Logan-Fouts/Plink/hardware/plink_freecad/Plink Models.FCStd

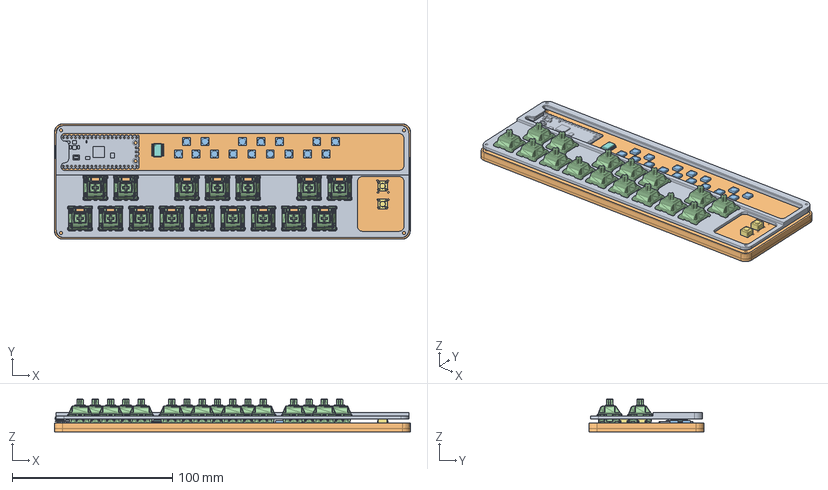
[picture p2: CAD file, 2026-11-08]
hardware/plink_freecad/Plink Models.FCStd
222.1 x 72.0 x 20.4 mm
Top Plate v1.0
Pcb_fa8d
LED3_SMD Neopixel 5050_70e6c0d70468 x 16
STEP translator 7.5 1.1 x 16
STEP translator 7.5 1.2 x 16
STEP translator 7.5 1.3 x 16
SW1_SW_PUSH_6mm_0a506ad786f1 x 2
BODY_MSA24
LEAD_MSA24
LEAD_MSA001
LEAD_MSA002
LEAD_MSA003
LEAD_MSA004
LEAD_MSA005
LEAD_MSA006
LEAD_MSA007
LEAD_MSA008
LEAD_MSA009
LEAD_MSA010
LEAD_MSA011
LEAD_MSA012
LEAD_MSA013
LEAD_MSA014
LEAD_MSA015
LEAD_MSA016
LEAD_MSA017
LEAD_MSA018
LEAD_MSA019
LEAD_MSA020
LEAD_MSA021
LEAD_MSA022
LEAD_MSA023
RaspberryPi_Pico_Module_KiCad
Bottom Plate
