Logan-Fouts/Plink/hardware/plink_kicad/CD74HC4067_Breakout/Plink Models-CD74HC4067 Breakout.step

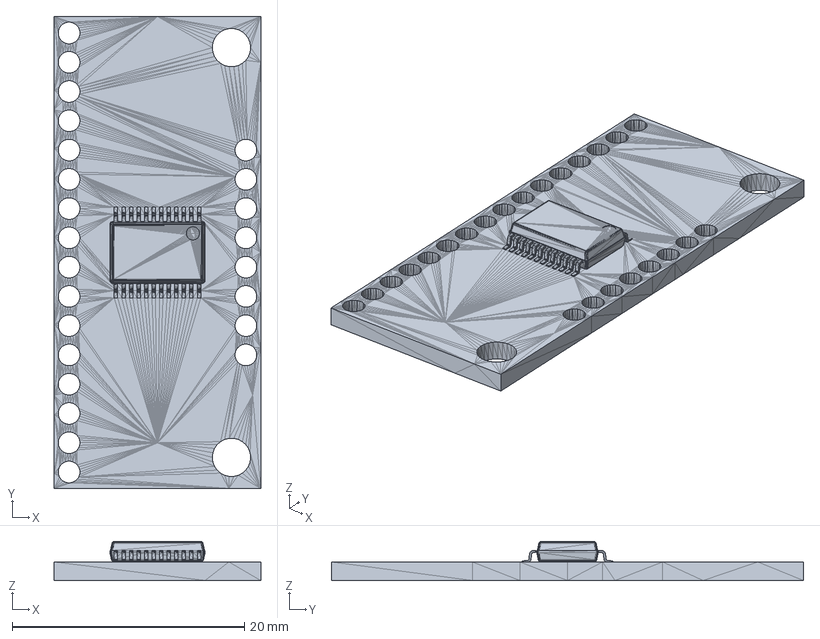
[picture p3: CAD file, 2026-10-27]
hardware/plink_kicad/CD74HC4067_Breakout/Plink Models-CD74HC4067 Breakout.step
17.8 x 40.6 x 3.36 mm
