Logan-Fouts/Plink/hardware/plink_kicad/CD74HC4067_Breakout/ul_CD74HC4067SM96/DB0024A.stp

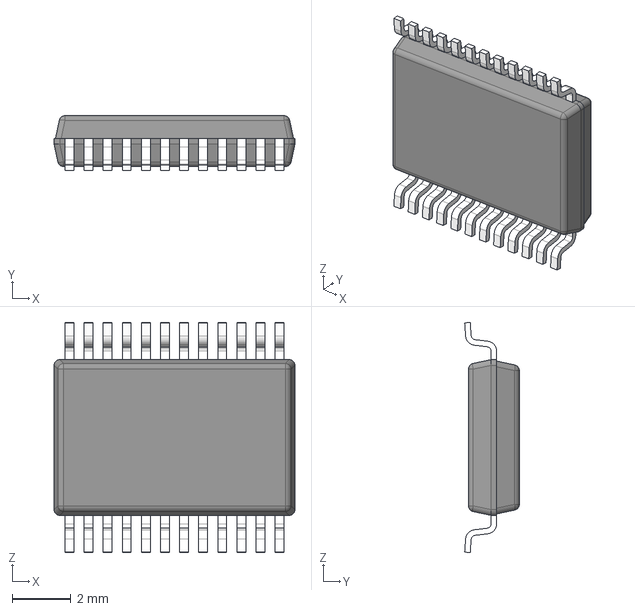
[picture p4: CAD file, 2026-10-27]
hardware/plink_kicad/CD74HC4067_Breakout/ul_CD74HC4067SM96/DB0024A.stp
8.20 x 1.86 x 7.83 mm
BODY_MSA24
LEAD_MSA24 x 24
