Logan-Fouts/Plink/hardware/plink_freecad/Plink Models-Top Plate v1.0.step

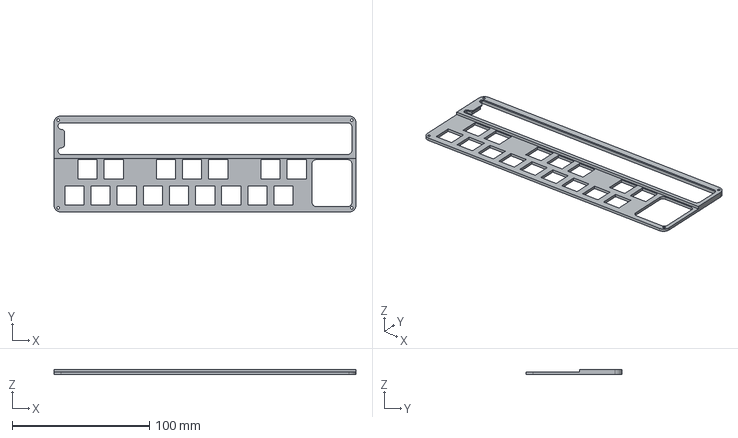
[picture p5: CAD file, 2026-11-03]
hardware/plink_freecad/Plink Models-Top Plate v1.0.step
220.0 x 70.0 x 4.00 mm
