Logan-Fouts/Plink/hardware/plink_freecad/Plink Models-Rotary Encoder.step

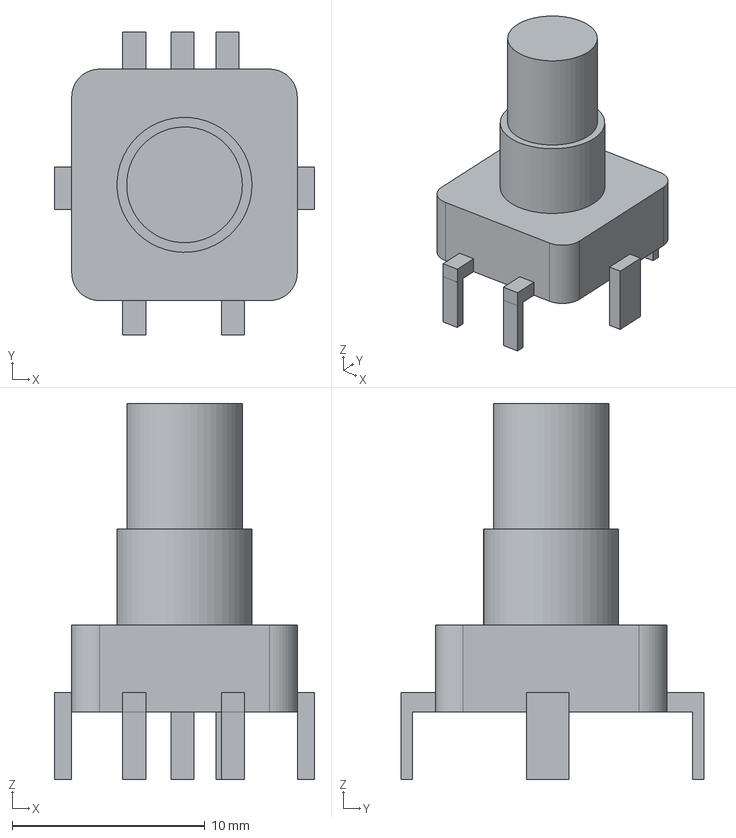
[picture p6: CAD file, 2026-11-02]
hardware/plink_freecad/Plink Models-Rotary Encoder.step
13.5 x 15.7 x 19.5 mm
