Logan-Fouts/Plink/hardware/plink_freecad/Plink Models-SMD Neopixel 5050.step

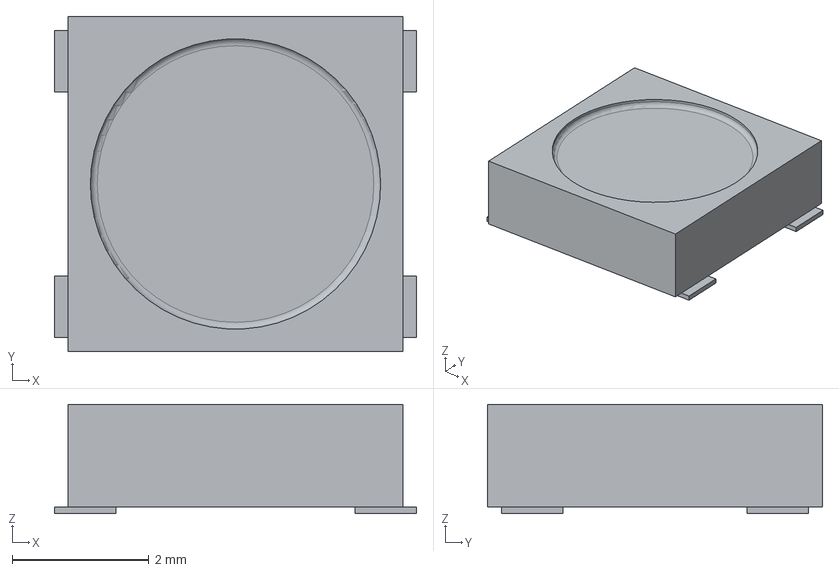
[picture p7: CAD file, 2026-10-25]
hardware/plink_freecad/Plink Models-SMD Neopixel 5050.step
5.30 x 4.90 x 1.60 mm
