Logan-Fouts/Plink/hardware/plink_freecad/8mm Neopixel.step

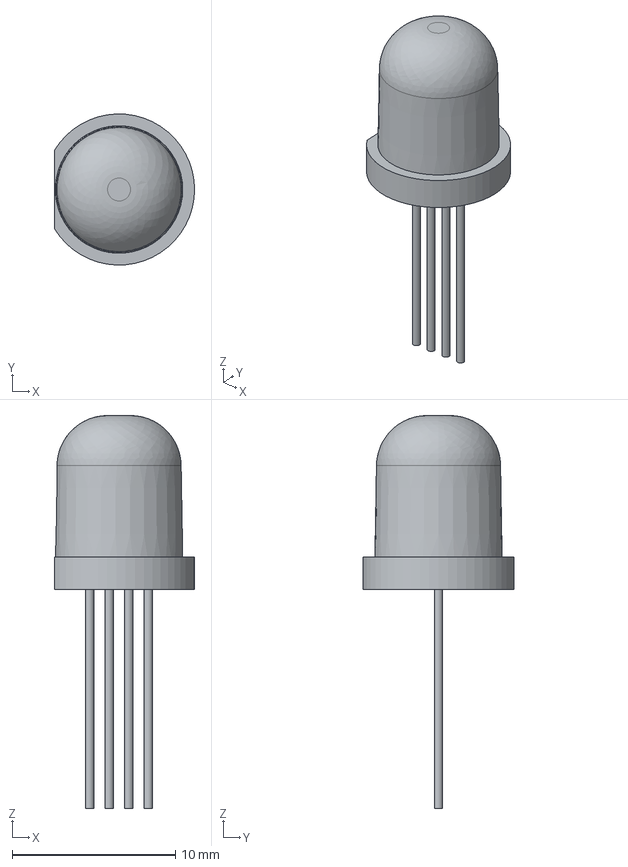
[picture p8: CAD file, 2026-10-25]
hardware/plink_freecad/8mm Neopixel.step
8.58 x 9.24 x 24.1 mm
