Logan-Fouts/Plink/hardware/plink_freecad/SS49 SIP-3 Hall Sensor-SS49 SIP-3 Body.step

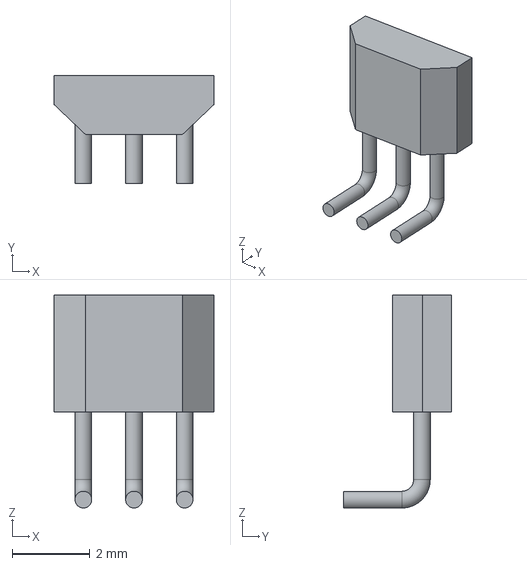
[picture p9: CAD file, 2026-10-25]
hardware/plink_freecad/SS49 SIP-3 Hall Sensor-SS49 SIP-3 Body.step
4.10 x 2.77 x 5.47 mm
