Logan-Fouts/Plink/hardware/plink_freecad/SW_Cherry_HE_SS49.step

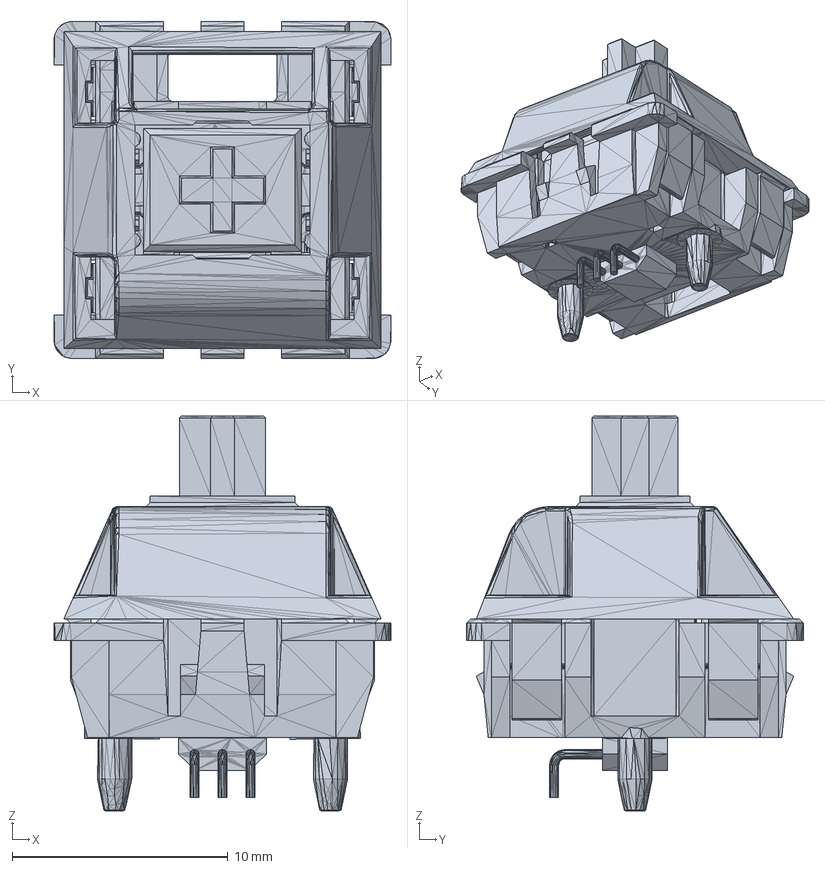
[picture p10: CAD file, 2026-10-25]
hardware/plink_freecad/SW_Cherry_HE_SS49.step
15.6 x 15.6 x 18.3 mm
STEP translator 7.5 1.1
STEP translator 7.5 1.2
STEP translator 7.5 1.3
