Logan-Fouts/Plink/(list of files, cad)

Other CAD files:
hardware/plink_freecad/SS49 SIP-3 Hall Sensor-SS49 SIP-3 Body.obj
hardware/plink_freecad/SW_Cherry_HE_SS49.stl
hardware/plink_kicad/CD74HC4067_Breakout/ul_CD74HC4067SM96/DB0024A.stl
