Logan-Fouts/Plink/hardware/plink_kicad/plink_kicad.kicad_pcb

## KiCad design hardware/plink_kicad/plink_kicad.kicad_pcb (2026-11-08)

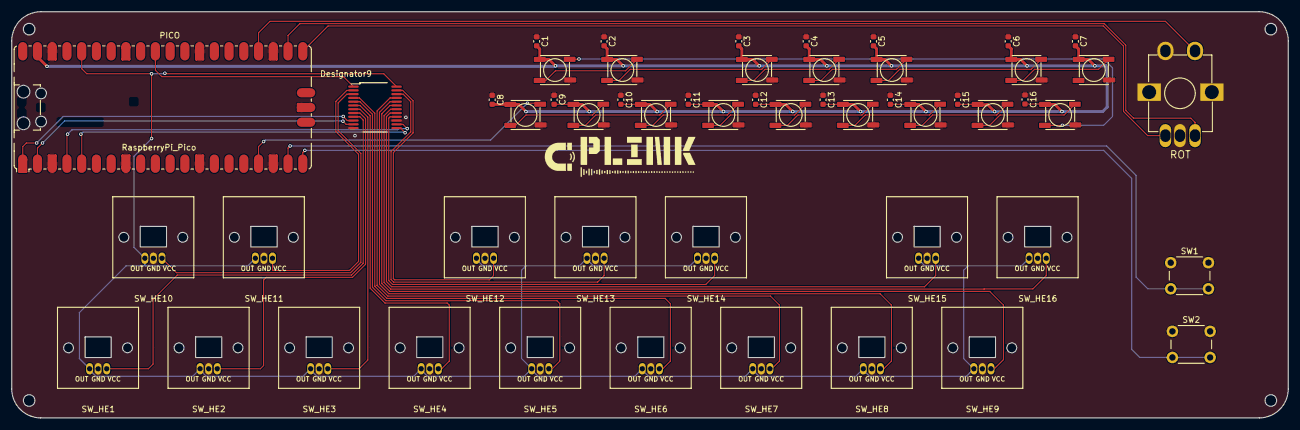
[picture p11: board plink_kicad.kicad_pcb from above]

Board: 2 copper layers, 220.0 x 70.0 mm, 53 parts (0 on the bottom side), 45 nets.

Parts:
C1, C2, C3, C4, C5, C6, C7, C8, C9, C10, C11, C12, C13, C14, C15, C16: C; C_0603_1608Metric
LED1, LED2, LED3, LED4, LED5, LED6, LED7, LED8, LED9, LED10, LED11, LED12, LED13, LED14, LED15, LED16: SMD Neopixel 5050
PICO: RaspberryPi_Pico; RaspberryPi_Pico_SMD_HandSolder
ROT: Rotationsenkoder 1530 pv med tryckknapp
SW1, SW2: SW_Push; SW_PUSH_6mm
SW_HE1, SW_HE2, SW_HE3, SW_HE4, SW_HE5, SW_HE6, SW_HE7, SW_HE8, SW_HE9, SW_HE10, SW_HE11, SW_HE12, SW_HE13, SW_HE14, SW_HE15, SW_HE16: SW_Cherry_MX_1.00u_PCB_HALL_EFFECT; SW_Cherry_MX_HE_1.00u
U2: CD74HC4067SM96; DB0024A_M

Connections:
+3V: PICO.36 (3V3), SW_HE1.1 (VCC), SW_HE2.1 (VCC), SW_HE3.1 (VCC), SW_HE4.1 (VCC), SW_HE5.1 (VCC), SW_HE6.1 (VCC), SW_HE7.1 (VCC), SW_HE8.1 (VCC), SW_HE9.1 (VCC), SW_HE10.1 (VCC), SW_HE11.1 (VCC), SW_HE12.1 (VCC), SW_HE13.1 (VCC), SW_HE14.1 (VCC), SW_HE15.1 (VCC), SW_HE16.1 (VCC), U2.24 (VCC)
+5V: C1.2, C2.2, C3.2, C4.2, C5.2, C6.2, C7.2, C8.2, C9.2, C10.2, C11.2, C12.2, C13.2, C14.2, C15.2, C16.2, LED1.1 (VDD), LED2.1 (VDD), LED3.1 (VDD), LED4.1 (VDD), LED5.1 (VDD), LED6.1 (VDD), LED7.1 (VDD), LED8.1 (VDD), LED9.1 (VDD), LED10.1 (VDD), LED11.1 (VDD), LED12.1 (VDD), LED13.1 (VDD), LED14.1 (VDD), LED15.1 (VDD), LED16.1 (VDD), PICO.39 (VSYS)
CH0: SW_HE1.3 (OUT), U2.9 (I0)
CH1: SW_HE2.3 (OUT), U2.8 (I1)
CH2: SW_HE3.3 (OUT), U2.7 (I2)
CH3: SW_HE4.3 (OUT), U2.6 (I3)
CH4: SW_HE5.3 (OUT), U2.5 (I4)
CH5: SW_HE6.3 (OUT), U2.4 (I5)
CH6: SW_HE7.3 (OUT), U2.21 (I10)
CH7: SW_HE8.3 (OUT), U2.20 (I11)
CH8: SW_HE9.3 (OUT), U2.19 (I12)
CH9: SW_HE10.3 (OUT), U2.3 (I6)
CH10: SW_HE11.3 (OUT), U2.2 (I7)
CH11: SW_HE12.3 (OUT), U2.23 (I8)
CH12: SW_HE13.3 (OUT), U2.22 (I9)
CH13: SW_HE14.3 (OUT), U2.16 (I15)
CH14: SW_HE15.3 (OUT), U2.17 (I14)
CH15: SW_HE16.3 (OUT), U2.18 (I13)
GND: C1.1, C2.1, C3.1, C4.1, C5.1, C6.1, C7.1, C8.1, C9.1, C10.1, C11.1, C12.1, C13.1, C14.1, C15.1, C16.1, LED1.3 (VSS), LED2.3 (VSS), LED3.3 (VSS), LED4.3 (VSS), LED5.3 (VSS), LED6.3 (VSS), LED7.3 (VSS), LED8.3 (VSS), LED9.3 (VSS), LED10.3 (VSS), LED11.3 (VSS), LED12.3 (VSS), LED13.3 (VSS), LED14.3 (VSS), LED15.3 (VSS), LED16.3 (VSS), PICO.3 (GND), PICO.8 (GND), PICO.13 (GND), PICO.18 (GND), PICO.23 (GND), PICO.28 (GND), PICO.38 (GND), ROT.3 (C_COM), ROT.4 (D_SW), ROT.6 (MP), ROT.7 (MP), SW1.1, SW2.1, SW_HE1.2 (GND), SW_HE2.2 (GND), SW_HE3.2 (GND), SW_HE4.2 (GND), SW_HE5.2 (GND), SW_HE6.2 (GND), SW_HE7.2 (GND), SW_HE8.2 (GND), SW_HE9.2 (GND), SW_HE10.2 (GND), SW_HE11.2 (GND), SW_HE12.2 (GND), SW_HE13.2 (GND), SW_HE14.2 (GND), SW_HE15.2 (GND), SW_HE16.2 (GND), U2.12 (GND), U2.15 (E_N)
LED DIN: LED1.4 (DIN), PICO.17 (GPIO13)
unnamed: LED1.2 (DOUT), LED2.4 (DIN)
unnamed: LED2.2 (DOUT), LED3.4 (DIN)
unnamed: LED3.2 (DOUT), LED4.4 (DIN)
unnamed: LED4.2 (DOUT), LED5.4 (DIN)
unnamed: LED5.2 (DOUT), LED6.4 (DIN)
unnamed: LED6.2 (DOUT), LED7.4 (DIN)
unnamed: LED7.2 (DOUT), LED8.4 (DIN)
unnamed: LED8.2 (DOUT), LED9.4 (DIN)
unnamed: LED9.2 (DOUT), LED10.4 (DIN)
unnamed: LED10.2 (DOUT), LED11.4 (DIN)
unnamed: LED11.2 (DOUT), LED12.4 (DIN)
unnamed: LED12.2 (DOUT), LED13.4 (DIN)
unnamed: LED13.2 (DOUT), LED14.4 (DIN)
unnamed: LED14.2 (DOUT), LED15.4 (DIN)
unnamed: LED15.2 (DOUT), LED16.4 (DIN)
ROT A: PICO.21 (GPIO16), ROT.1 (A_OUT)
ROT B: PICO.22 (GPIO17), ROT.2 (B_OUT)
ROT SW: PICO.24 (GPIO18), ROT.5 (E_SW)
S0: PICO.1 (GPIO0), U2.10 (S0)
S1: PICO.2 (GPIO1), U2.11 (S1)
S2: PICO.4 (GPIO2), U2.14 (S2)
S3: PICO.5 (GPIO3), U2.13 (S3)
SIG: PICO.31 (GPIO26_ADC0), U2.1 (COMMON_I_O)
Shift Down: PICO.20 (GPIO15), SW2.2
Shift Up: PICO.19 (GPIO14), SW1.2
