Logan-Fouts/Plink/(commit log)

2026-10-18 Basic Functionality - Key Presses for Midi and Serial - No velocity or halleffect support yet
2026-10-18 Pico vs code extension cmake
2026-10-18 Update to work with hall switches
2026-10-19 - Start neopixel LED support - Remove magic numbers - Docs for mux
2026-10-22 Seperate out debug writing and led logic from hw specific implementations
2026-10-23 button test suite
2026-10-25 Cad Work: -Hall sensor footprint/3d model -SMD 5050 neopixel footprint/3d model - THT 8mm neopixel footprint/3d model -HE cherry mx switch + sensor combined/3d model(s)
    [8mm Neopixel.step, Plink Models-SMD Neopixel 5050.step, Plink Models.FCStd, SS49 SIP-3 Hall Sensor-SS49 SIP-3 Body.obj, SS49 SIP-3 Hall Sensor-SS49 SIP-3 Body.step, SW_Cherry_HE_SS49.step, SW_Cherry_HE_SS49.stl, plink_kicad.kicad_pcb]
2026-10-27 Cad work
    [CD74HC4067_Breakout.kicad_pcb, CD74HC4067_Breakout.kicad_sch, DB0024A.stl, DB0024A.stp, Plink Models-CD74HC4067 Breakout.step, Plink Models.FCStd, plink_kicad.kicad_pcb, plink_kicad.kicad_sch]
2026-10-28 updated models
    [Plink Models.FCStd]
2026-10-29 semitone shifting
    [Plink Models.FCStd, plink_kicad.kicad_pcb, plink_kicad.kicad_sch, tmp.kicad_pcb, tmp.kicad_sch]
2026-11-02 mux stablization
    [Plink Models.FCStd, plink_kicad.kicad_pcb, plink_kicad.kicad_sch]
2026-11-02 kicad update
    [Plink Models-Rotary Encoder.step, Plink Models.FCStd, plink_kicad.kicad_pcb, plink_kicad.kicad_sch]
2026-11-03 Add linting, formatting and CI; rewrite docs
    - Rewrite README and DevDocs (rename Readme.md -> README.md)
    - Register lib/Unity as a proper git submodule
    - Add clang-format, clang-tidy and .editorconfig configs
    - Add format/lint scripts and a pre-commit auto-format hook
    - Format all sources and fix clang-tidy findings
    - Add GitHub Actions CI: format check, unit tests, firmware build + lint,
    and release on version tags
    [plink_kicad.kicad_pcb, plink_kicad.kicad_sch]
2026-11-05 pcb updates
    [plink_kicad.kicad_pcb, plink_kicad.kicad_sch]
2026-11-08 Freecad model updates
    [Plink Models.FCStd, plink_kicad.kicad_pcb]
